peri-7/penduin/list.md

## Electronics
1. Stepper motor | 42BYGHW804, NEMA17 48 mm body, 4.8 kg·cm, 5 mm shaft
2. Stepper driver | TMC2209
3. Magnetic encoder | AS5600
4. Microcontroller | Raspberry Pi Pico 2 W
5. Electrolytic capacitor | 100 µF
6. Ceramic capacitor | 100 nF
7. Motor cable | 24V
8. Encoder wires | 30 AWG

## Mechanical
1. Vertical arm | 3D-printed
2. Pendulum | 3D-printed
3. Ball bearing | 608ZZ
4. Tip mass | 2 x 50 cent coins
