peri-7/penduin/data/excitation_plan.png

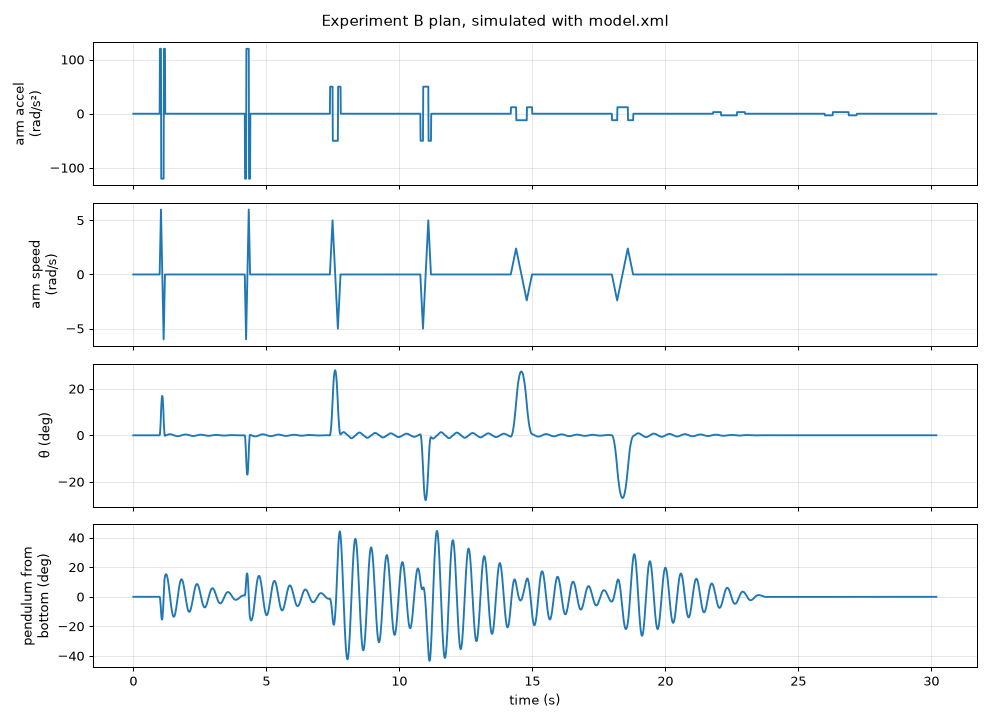
data/excitation_plan.png
