peri-7/penduin/data/sysid_A.png

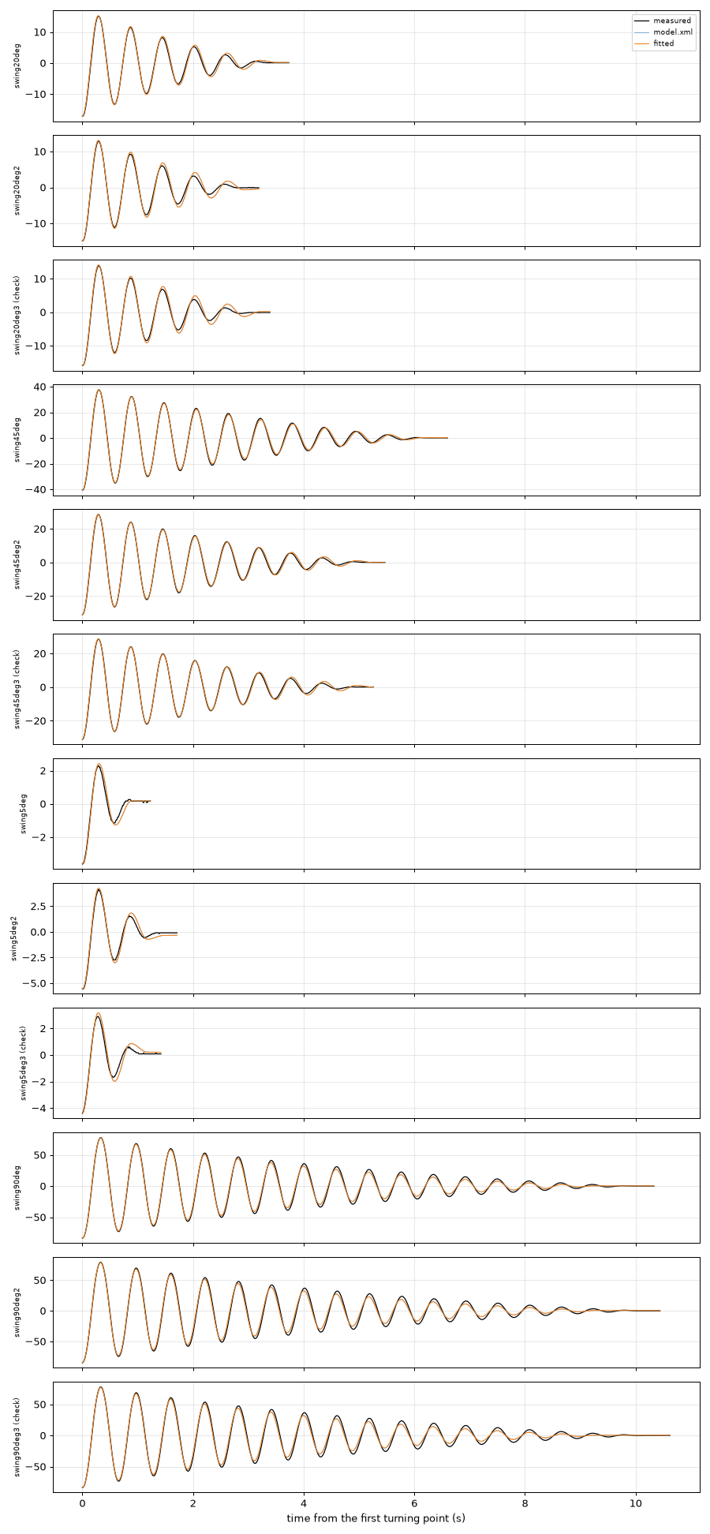
data/sysid_A.png
