peri-7/penduin/data/sysid_B.png

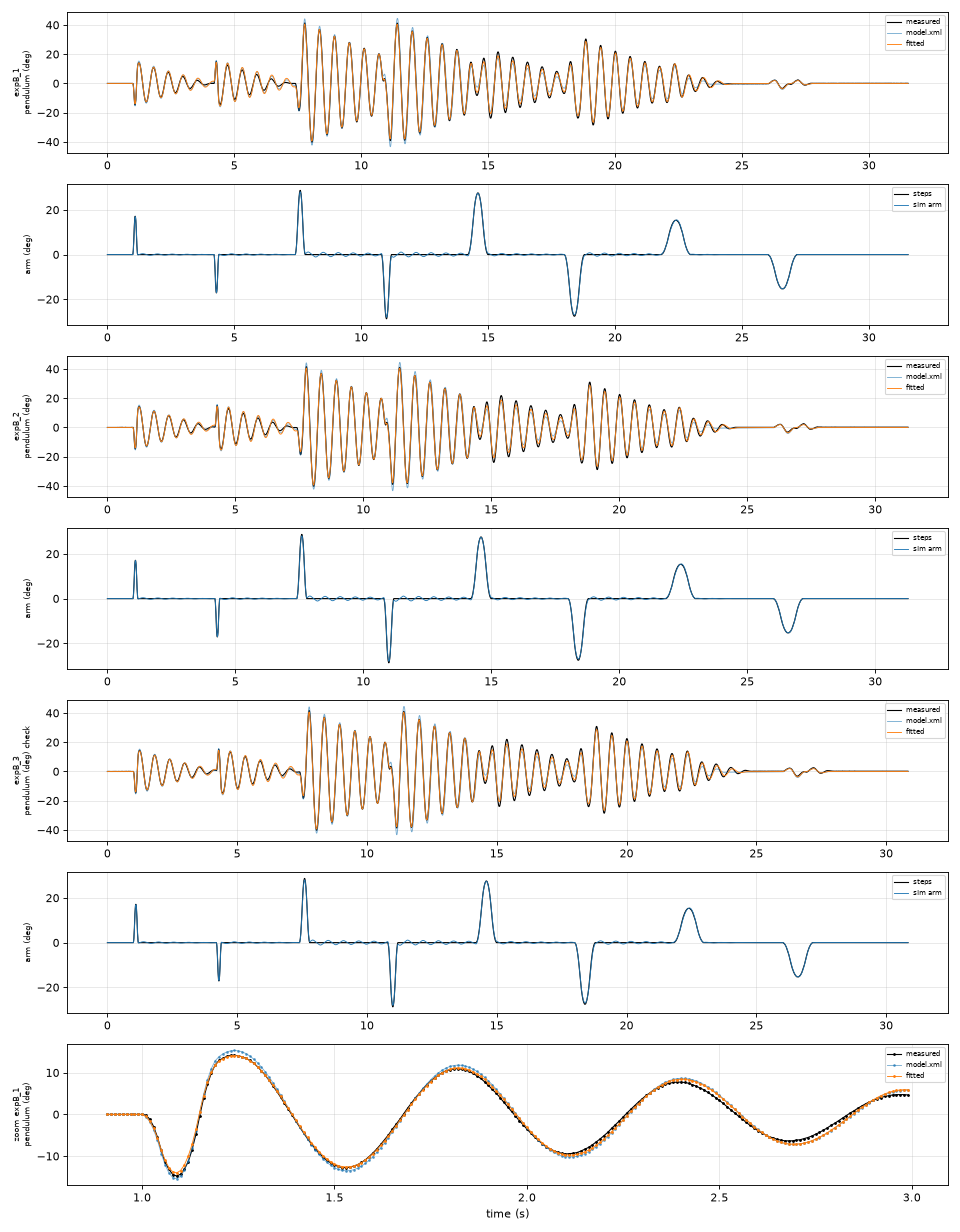
data/sysid_B.png
