peri-7/penduin/images/IMG_20261111_183600306.jpg

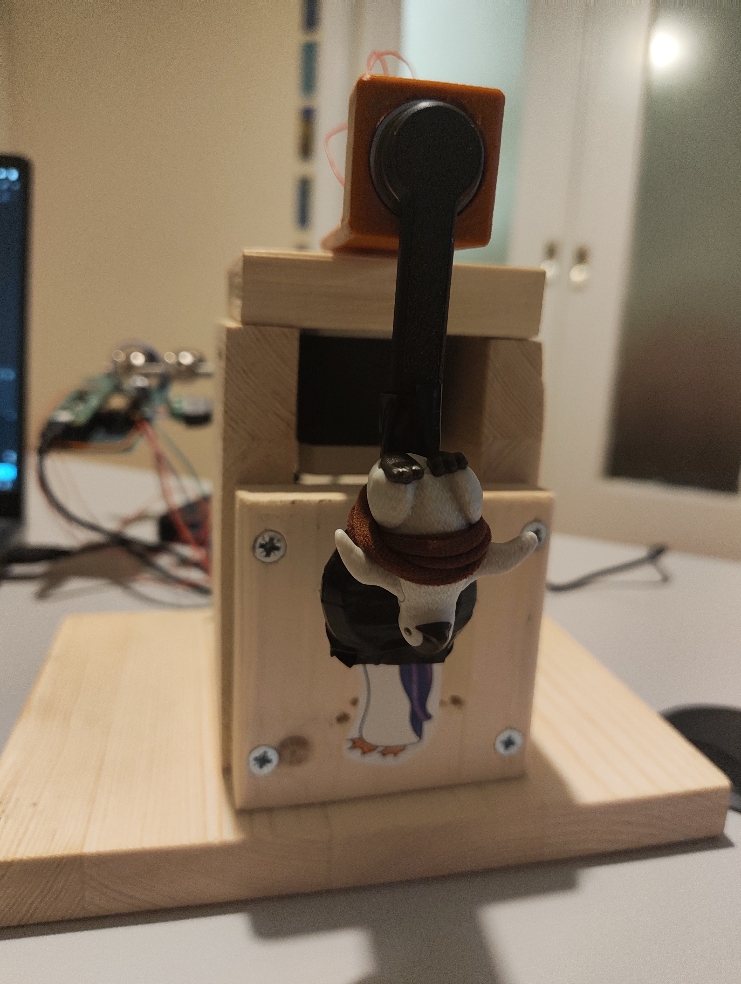
images/IMG_20261111_183600306.jpg
