peri-7/penduin/images/IMG_20261111_183626124.jpg

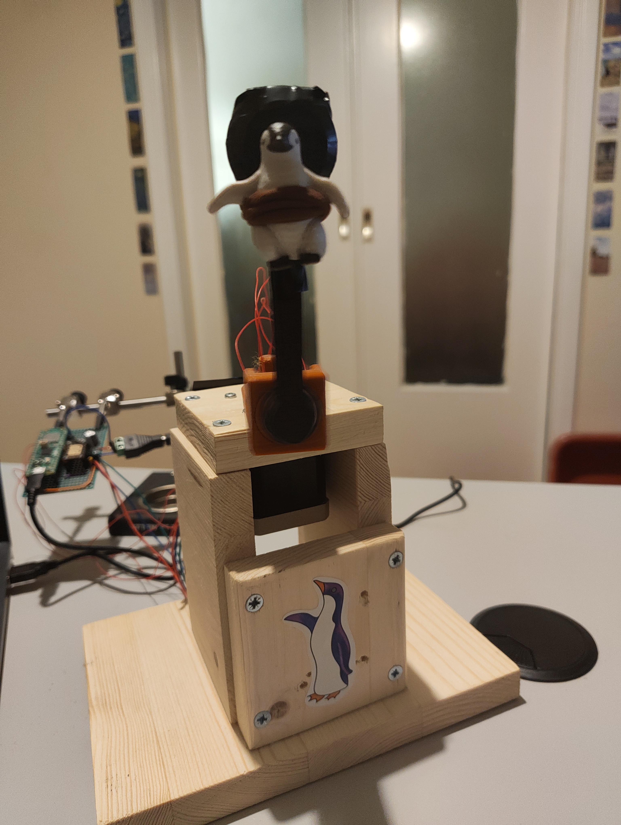
images/IMG_20261111_183626124.jpg
