peri-7/penduin/images/IMG_20261111_183635876.jpg

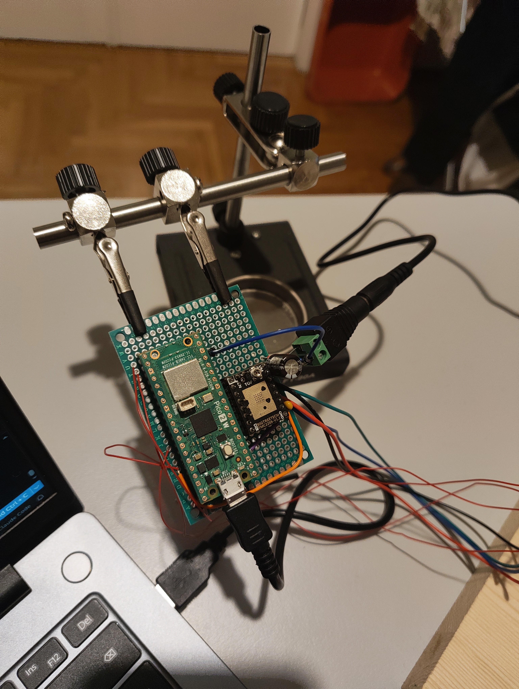
images/IMG_20261111_183635876.jpg
