peri-7/penduin/images/IMG_20261111_183653554.jpg

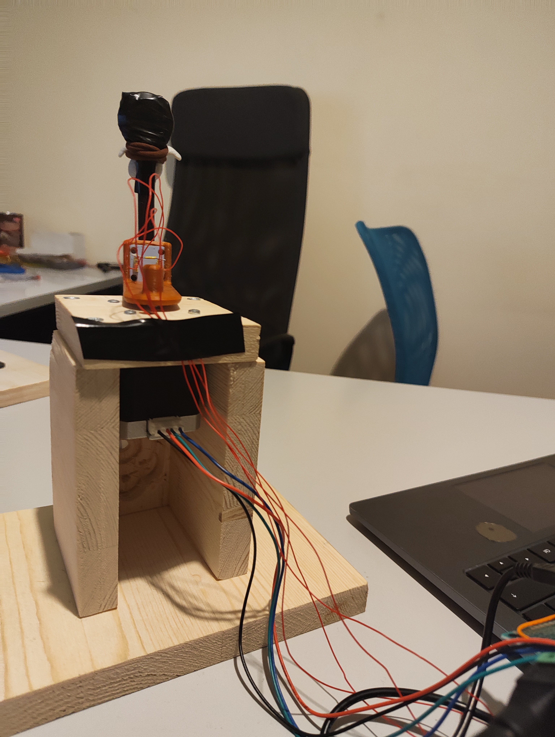
images/IMG_20261111_183653554.jpg
