peri-7/penduin/images/IMG_20261111_183659180.jpg

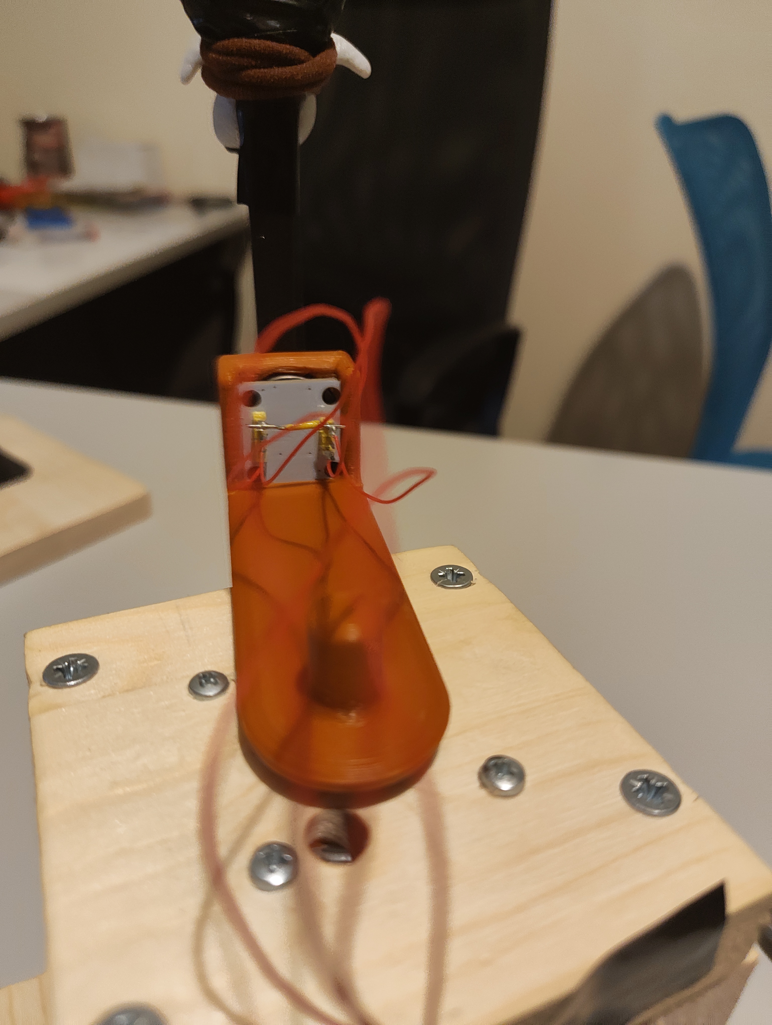
images/IMG_20261111_183659180.jpg
