peri-7/penduin/STLs/arm3.stl

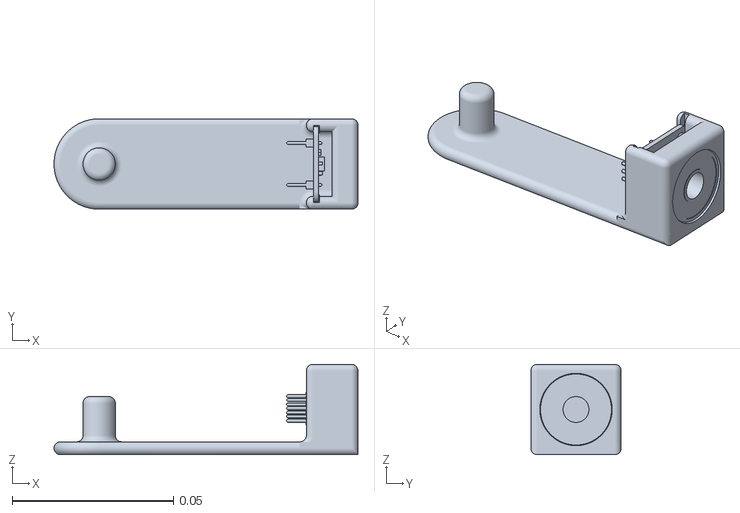
[picture p9: CAD file, 2026-11-04]
STLs/arm3.stl
0.0942 x 0.028 x 0.028
