peri-7/penduin/STLs/pendulum.stl

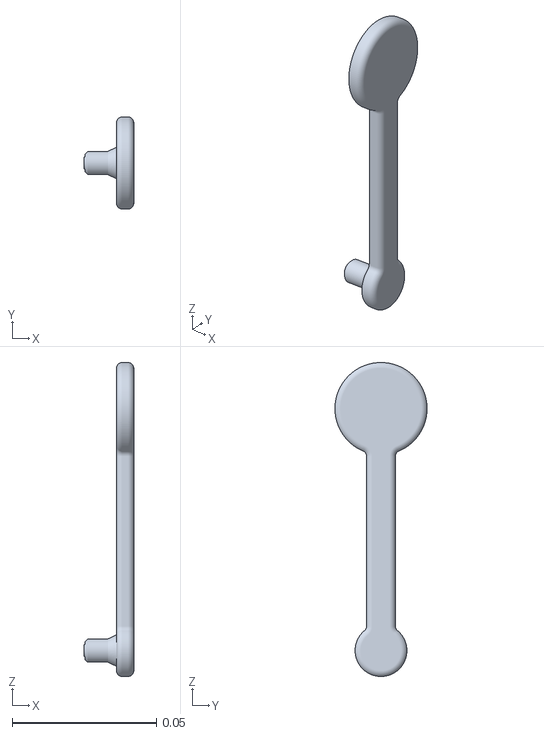
[picture p10: CAD file, 2026-10-31]
STLs/pendulum.stl
0.0172 x 0.032 x 0.109
