peri-7/penduin/STLs/arm.stl

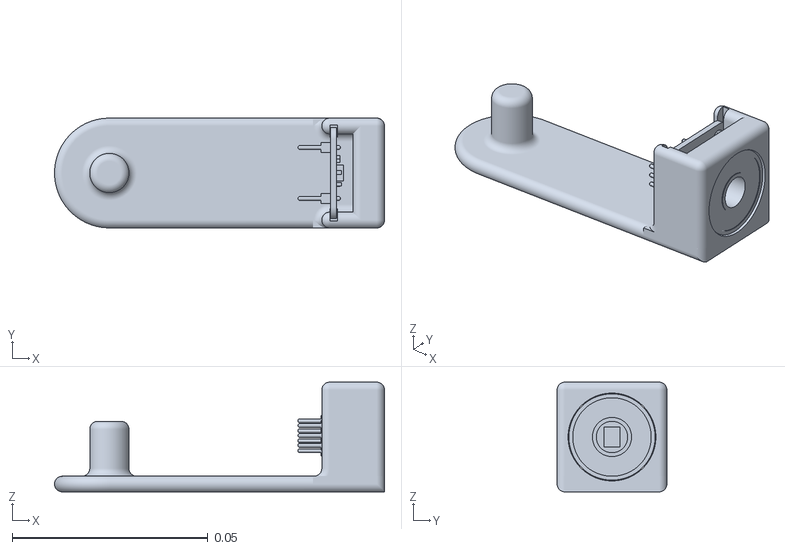
[picture p11: CAD file, 2026-10-31]
STLs/arm.stl
0.0842 x 0.028 x 0.028
