peri-7/penduin/STLs/nema17.stl

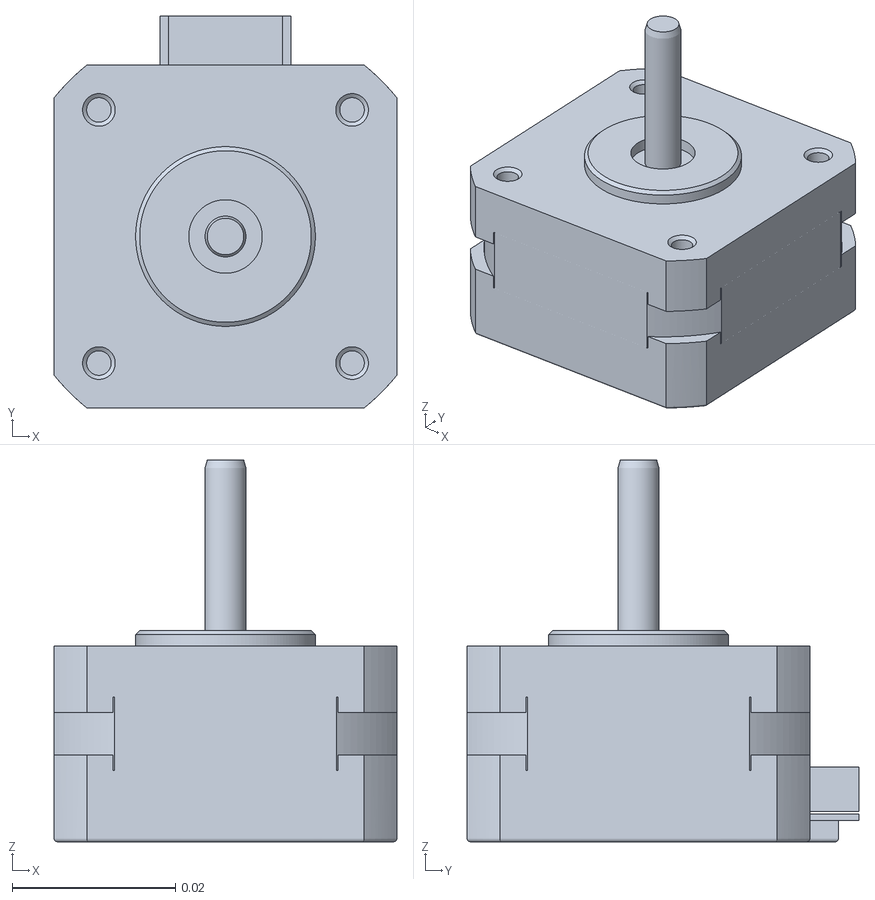
[picture p12: CAD file, 2026-10-31]
STLs/nema17.stl
0.042 x 0.048 x 0.0468
