peri-7/penduin/STLs/pendulum_coins.stl

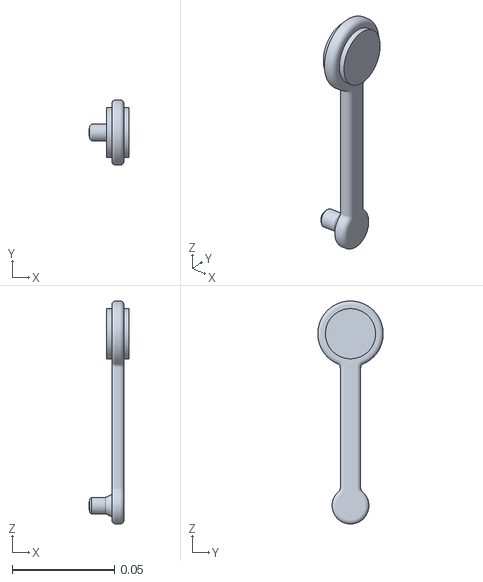
[picture p13: CAD file, 2026-10-31]
STLs/pendulum_coins.stl
0.0197 x 0.032 x 0.109
