peri-7/penduin/(list of files, cad)

Other CAD files:
STLs/pendulum2.stl
STLs/arm2.stl
STLs/body2.stl
