peri-7/penduin/data/swing_test.csv

# set_SF(2) returned 0 | conf 0x0300
time_us | raw
1456507087 | 3643
1456515157 | 3643
1456525157 | 3643
1456535157 | 3643
1456545157 | 3643
1456555157 | 3642
1456565157 | 3643
1456575157 | 3643
1456585157 | 3643
1456595157 | 3643
1456605157 | 3642
1456615157 | 3643
1456625157 | 3642
1456635157 | 3643
1456645157 | 3643
1456655157 | 3643
1456665157 | 3642
1456675157 | 3642
1456685157 | 3643
1456695157 | 3642
1456705157 | 3643
1456715157 | 3643
1456725157 | 3642
1456735157 | 3643
1456745157 | 3642
1456755157 | 3643
1456765157 | 3642
1456775157 | 3642
1456785157 | 3643
1456795157 | 3642
1456805157 | 3643
1456815157 | 3643
1456825157 | 3643
1456835157 | 3642
1456845157 | 3643
1456855157 | 3643
1456865157 | 3643
1456875157 | 3643
1456885157 | 3642
1456895157 | 3642
1456905157 | 3643
1456915157 | 3642
1456925157 | 3642
1456935157 | 3643
1456945157 | 3642
1456955157 | 3642
1456965157 | 3643
1456975157 | 3643
1456985157 | 3643
1456995157 | 3642
1457005157 | 3643
1457015157 | 3642
1457025157 | 3642
1457035157 | 3643
1457045157 | 3642
1457055157 | 3643
1457065157 | 3643
1457075157 | 3643
1457085157 | 3643
1457095157 | 3642
1457105157 | 3643
1457115157 | 3643
1457125157 | 3643
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
