peri-7/penduin/data/telemetry_idle_test.csv

# state: wait -> center the arm | then press any key to calibrate and run
# state: wait -> center the arm | then press any key to calibrate and run
# calibration ended -> raw_down: 3646 / raw_up: 1598
time_us | raw | steps | v | action | alpha | alpha_dot | loop_us | late | dropped
209435557 | 3645 | 0 | 0.000 | 0.000 | 3.1401 | 0.000 | 510 | 0 | 0
209445558 | 3645 | 0 | 0.000 | 0.000 | 3.1401 | 0.000 | 508 | 0 | 0
209455558 | 3645 | 0 | 0.000 | 0.000 | 3.1401 | 0.000 | 507 | 0 | 0
209465558 | 3646 | 0 | 0.000 | 0.000 | -3.1416 | 0.153 | 507 | 0 | 0
209475558 | 3646 | 0 | 0.000 | 0.000 | -3.1416 | 0.000 | 507 | 0 | 0
209485558 | 3645 | 0 | 0.000 | 0.000 | 3.1401 | -0.153 | 507 | 0 | 0
209495557 | 3646 | 0 | 0.000 | 0.000 | -3.1416 | 0.153 | 507 | 0 | 0
209505557 | 3646 | 0 | 0.000 | 0.000 | -3.1416 | 0.000 | 507 | 0 | 0
209515558 | 3646 | 0 | 0.000 | 0.000 | -3.1416 | 0.000 | 507 | 0 | 0
209525557 | 3645 | 0 | 0.000 | 0.000 | 3.1401 | -0.153 | 508 | 0 | 0
209535558 | 3646 | 0 | 0.000 | 0.000 | -3.1416 | 0.153 | 506 | 0 | 0
209545558 | 3645 | 0 | 0.000 | 0.000 | 3.1401 | -0.153 | 507 | 0 | 0
209555558 | 3645 | 0 | 0.000 | 0.000 | 3.1401 | 0.000 | 508 | 0 | 0
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
