peri-7/penduin/data/telemetry_isolation_test.csv

# state: wait -> center the arm | then press any key to calibrate and run
# calibration ended -> raw_down: 3644 / raw_up: 1596
time_us | raw | steps | v | action | alpha | alpha_dot | loop_us | late | dropped
1456130269 | 3644 | 0 | 0.000 | 0.000 | -3.1416 | 0.000 | 508 | 0 | 0
1456140270 | 3644 | 0 | 0.000 | 0.000 | -3.1416 | 0.000 | 507 | 0 | 0
1456150270 | 3644 | 0 | 0.000 | 0.000 | -3.1416 | 0.000 | 508 | 0 | 0
1456160269 | 3644 | 0 | 0.000 | 0.000 | -3.1416 | 0.000 | 508 | 0 | 0
1456170269 | 3644 | 0 | 0.000 | 0.000 | -3.1416 | 0.000 | 508 | 0 | 0
1456180270 | 3644 | 0 | 0.000 | 0.000 | -3.1416 | 0.000 | 507 | 0 | 0
1456190269 | 3644 | 0 | 0.000 | 0.000 | -3.1416 | 0.000 | 508 | 0 | 0
1456200270 | 3644 | 0 | 0.000 | 0.000 | -3.1416 | 0.000 | 507 | 0 | 0
1456210270 | 3645 | 0 | 0.000 | 0.000 | -3.1401 | 0.153 | 507 | 0 | 0
1456220270 | 3644 | 0 | 0.000 | 0.000 | -3.1416 | -0.153 | 506 | 0 | 0
1456230269 | 3644 | 0 | 0.000 | 0.000 | -3.1416 | 0.000 | 508 | 0 | 0
1456240270 | 3645 | 0 | 0.000 | 0.000 | -3.1401 | 0.153 | 508 | 0 | 0
1456250269 | 3645 | 0 | 0.000 | 0.000 | -3.1401 | 0.000 | 507 | 0 | 0
1456260270 | 3645 | 0 | 0.000 | 0.000 | -3.1401 | 0.000 | 507 | 0 | 0
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
