peri-7/penduin/firmware/stepper_motor/main.c

// control loop
#include <stdio.h>
#include <pico/stdlib.h>
#include <math.h>
#include <pico/stdio_usb.h>
#include <pico/multicore.h>
#include <pico/util/queue.h>
#include <hardware/watchdog.h>

#include "stepper.h"
#include "encoder.h"
#include "agent.h"

#define DT_US 10000
#define DT (DT_US * 1e-6f)
#define SF 2
#define FAILED_CNTS 3
#define CAL_N 100
#define CAL_SPREAD 4

static PIO pio;
static uint sm0, sm1, baud = 100*1000;
static alpha_t a;
static float th, th_dot, th_ddot, action;
static int32_t steps0;
static const char *reason = "";

static int cnt = 0, restart = 0;
static uint16_t raw = 0;

static queue_t write_q, read_q;

typedef enum STATES {
    WAIT, CALIBRATE, RUN, FAULT 
} state_t;

typedef struct {
    uint32_t t_us; 
    float a;
    float a_dot;
    float th;
    float th_dot;
    float action;
} obs_t;

static void core1_main(void){
    while(true){
        obs_t obs; // placeholder in case we need it, perhaps the observation space
        while(queue_try_remove(&write_q, &obs)) 
            printf("%lu,%f,%f,%f,%f,%f\n", (unsigned long)obs.t_us, obs.a, obs.a_dot, obs.th, obs.th_dot, obs.action);
        int c = getchar_timeout_us(0);
        if(c != PICO_ERROR_TIMEOUT) {
            char k = (char)c;
            queue_try_add(&read_q, &k);
        }
        sleep_ms(1);
    }
}
/*  Given by the agent.c script now
static float controller(float a, float a_dot, float th, float th_dot){
    if (fabs(a) < 0.15) 
        return -(-8.61077392*th + 398.98540392*a  -6.56925727*th_dot + 33.09880381*a_dot); // placeholder for tests
    else return 0;
} */



// Bench check of the exported network, run once at boot with the motor still.
// Expected values for checkpoints/sac_QR101_675000_steps (recompute them for another model):
//   +0.988925, -0.516716, +0.466328, -0.923270
static void agent_selftest(void){
    const float in[4][4] = {    // a, a_dot, th, th_dot (raw rad, rad/s: controller() scales them)
        { 3.141593f,  0.0f,  0.0f,  0.0f},
        { 0.1f,       0.5f,  0.2f,  1.0f},
        {-0.05f,     -1.0f, -0.3f, -2.0f},
        { 2.0f,       5.0f,  0.5f,  8.0f},
    };
    for(int k=0; k<4; k++)
        printf("# selftest: controller(%f, %f, %f, %f) = %f\n", in[k][0], in[k][1], in[k][2], in[k][3],
               controller(in[k][0], in[k][1], in[k][2], in[k][3]));

    // time 100 calls: mean and worst case
    uint32_t total = 0, worst = 0;
    float sink = 0;     // printed, so the calls can't be optimized away
    for(int k=0; k<100; k++){
        const float *x = in[k % 4];
        uint32_t t0 = time_us_32();
        sink += controller(x[0], x[1], x[2], x[3]);
        uint32_t d = time_us_32() - t0;
        total += d;
        if(d > worst) worst = d;
    }
    printf("# selftest: controller() mean %.1f us, worst %lu us (sink %f)\n",
           total / 100.0f, (unsigned long)worst, sink);
}

int calibrate(){
    // take 100 measurments of raw_down
    uint16_t cal[CAL_N]; 
    absolute_time_t next = get_absolute_time();
    for(int k=0; k<CAL_N; k++){
        next = delayed_by_us(next, DT_US);
        if(read_raw_angle(i2c0, &cal[k]) != 2){
            reason = "read failures";
            printf("# state: calibrate -> read failed during calibration\n");
            return -1;
        }
        sleep_until(next);
    }
    // find the spread to check stillness
    int lo = 0, hi = 0;
    for(int k=0; k<CAL_N; k++){
        int d = wrap_counts((int)cal[k] - (int)cal[0]);
        if(d < lo) lo = d;
        if(d > hi) hi = d;
    }
    if(hi - lo > CAL_SPREAD){
        reason = "pend. not still";
        printf("# state: calibrate -> pendulum not still: spread %d counts. Let it settle and run again\n", hi - lo);
        return 1;
    }
    // compute raw_up and start alpha_t a
    uint16_t raw_down = raw_average(cal, CAL_N);
    a.raw_up = (raw_down + 2048) % 4096;

    printf("# calibration ended -> raw_down: %d / raw_up: %d\n", raw_down, a.raw_up);
    return 0;

}

int main()
{
    // init all hardware
    char key = 'a'; obs_t obs;
    // stdio_usb_init() must run on core 0 (it owns the default alarm pool), or it returns false and USB never enumerates
    stdio_init_all();
    queue_init(&write_q, sizeof(obs_t), 64); 
    queue_init(&read_q, sizeof(char), 64);
    multicore_launch_core1(core1_main);
    while(!stdio_usb_connected()) sleep_ms(100);
    if(watchdog_enable_caused_reboot()) printf("# rebooted by watchdog\n");
    as5600_init(i2c0, baud, SDA_PIN, CLK_PIN);
    init_move_pio(&pio, &sm0);
    init_read_pio(&pio, &sm1);
    agent_selftest();
    state_t st = WAIT;


    absolute_time_t next = get_absolute_time();
    while (true) {
// ------------------------------------------------------------------------        
        if (st == WAIT){
            watchdog_disable();
            // while WAIT, move the arm at theta=0
            absolute_time_t prompt = get_absolute_time();
            while(!queue_try_remove(&read_q, &key)){
                if(time_reached(prompt)){
                    printf("# state: wait -> center the arm, then press s to calibrate and run\n");
                    prompt = make_timeout_time_ms(2000);
                }
                sleep_ms(10);
            }
            st = CALIBRATE;

        }
// ------------------------------------------------------------------------
        if (st == CALIBRATE){
            int err = set_SF(i2c0, SF);
            if (err != 0) { reason = "SF failure"; st = FAULT; continue; }
            int c = calibrate();
            if (c == 0) {
                while(queue_try_remove(&read_q, &key)); // empty queue
                cnt = 0; restart = 1; 
                th_dot = 0; th_ddot = 0; 
                steps0 = read_steps(pio, sm1);
                
                printf("t_us,alpha,alpha_dot,theta,theta_dot,action\n");
                watchdog_enable(50, true);
                next = get_absolute_time();
                st = RUN;
            }
            else if (c == 1) st = WAIT;
            else st = FAULT; 
        }
// ------------------------------------------------------------------------        
        if (st == RUN){
            next = delayed_by_us(next, DT_US);
            watchdog_update();
            // stop RUN if key is pressed
            if(queue_try_remove(&read_q, &key)) {
                // if(key == 'w') while(1) ; // watchdog test
                set_speed(0, pio, sm0);
                st = WAIT;
                continue;
            }
            // read angle 'alpha' and 'theta'
            if(read_raw_angle(i2c0, &raw) != 2){
                restart = 1;
                if(++cnt >= FAILED_CNTS){
                    reason = "read failures";
                    st = FAULT;
                    continue;
                }
            }
            else {
                cnt = 0; 
                if (restart == 1) {
                    alpha_start(&a, raw);
                    restart = 0;
                }
                else
                    alpha_update(&a, raw, DT);
            }
            th = steps2rad(pio, sm1, steps0);
            if(fabsf(th) > TH_LIMIT){
                reason = "theta passed the limit";
                st = FAULT;
                continue;                
            }
            
            // control u = th_ddot -> command th_dot
            action = controller(a.alpha, a.alpha_dot, th, th_dot);
            if(action > 1) action = 1;
            if(action < -1) action = -1;
            th_ddot = action*MAX_ACCEL;
            th_dot = th_dot + th_ddot*DT;
            if(th_dot > VMAX) th_dot = VMAX;
            if(th_dot < -VMAX) th_dot = -VMAX;
            set_speed(th_dot, pio, sm0);

            // telemetry: queued here, printed by core 1 (never print on core 0 in RUN)
            obs.t_us = time_us_32();
            obs.a = a.alpha; obs.a_dot = a.alpha_dot;
            obs.th = th; obs.th_dot = th_dot;
            obs.action = action;
            queue_try_add(&write_q, &obs);

            sleep_until(next);
        }
        
// ------------------------------------------------------------------------       
        if (st == FAULT){
            watchdog_disable();
            set_speed(0, pio, sm0);

            printf("# state: fault -> reason (%s) -> press 'r' to restart\n", reason);
            queue_remove_blocking(&read_q, &key);
            if (key == 'r') st = WAIT;
            
        }
    }
}
