peri-7/penduin/firmware/stepper_motor/weights.h

#ifndef WEIGHTS_H_
#define WEIGHTS_H_

#define HID_DIM 128
#define OBS_DIM 5

float latent_pi_0_weight[640] = {
    1.00472367e+00f, 8.57551303e-03f, -4.38878477e-01f, 9.96006668e-01f, -1.27572465e+00f, 3.03815365e-01f, 2.42288083e-01f, -1.78152174e-01f, 7.76956677e-01f, -2.45711595e-01f, 3.64170432e-01f, 2.07262874e-01f, 6.49802327e-01f, -3.54047269e-02f, -8.72977853e-01f, 6.44448042e-01f, 2.36154646e-01f, -2.82429993e-01f, 8.34474385e-01f, -4.54063684e-01f, -7.36880898e-01f, -3.62128258e-01f, 2.84556299e-01f, -1.08680224e+00f, 6.62827611e-01f, -1.07019663e+00f, 3.27106416e-01f, 4.48049754e-01f, -1.79349804e+00f, 8.35971773e-01f, -4.97868001e-01f, -1.70328572e-01f, 7.49748528e-01f, -8.04345787e-01f, 1.11326969e+00f, -1.65094063e-01f, -4.21123244e-02f, 2.73985267e-02f, 2.43213281e-01f, -7.24527955e-01f, 9.05886412e-01f, -5.49808621e-01f, 9.73998383e-02f, 1.38167918e-01f, -3.35405797e-01f, -4.78786379e-01f, -8.12184155e-01f, -2.79765695e-01f, -3.43021810e-01f, -1.35856882e-01f, -3.69427532e-01f, 1.03107922e-01f, 9.48176920e-01f, -1.50789008e-01f, 8.83288562e-01f, -7.99347937e-01f, 9.22553055e-03f, 6.43830895e-02f, -1.24776173e+00f, 3.38700294e-01f, 2.13911653e-01f, -1.07026689e-01f, 4.92457777e-01f, 1.64197445e+00f, 3.40656817e-01f, -8.42467487e-01f, 2.23995205e-02f, 3.20302904e-01f, -7.87458479e-01f, -7.24197805e-01f, -7.16100857e-02f, 3.68690819e-01f, 3.53721678e-01f, -9.41933393e-01f, 6.87083185e-01f, -1.29606977e-01f, -1.34506851e-01f, 1.71444431e-01f, -9.48713362e-01f, 9.83336866e-02f, 5.70309818e-01f, -1.83577687e-01f, 2.59470463e-01f, 8.36640060e-01f, -1.20214328e-01f, -3.7438553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
};

float latent_pi_2_weight[16384] = {
    1.12401359e-01f, -3.15009244e-02f, 6.83705330e-01f, 1.97763473e-01f, 1.06157012e-01f, 8.29832852e-02f, -5.43609321e-01f, 2.31251001e-01f, 1.80339962e-01f, -8.72095048e-01f, 3.55085939e-01f, -4.34811503e-01f, 5.27683459e-02f, 1.60577977e+00f, 3.97738993e-01f, 6.60138786e-01f, -5.31487048e-01f, -5.76764464e-01f, 4.03484523e-01f, -7.51799166e-01f, 1.09941065e-01f, -9.92251813e-01f, 3.79675090e-01f, 6.17093325e-01f, -8.05040956e-01f, -6.89531416e-02f, -8.73450935e-03f, 8.42211485e-01f, 5.32076299e-01f, 5.89501858e-01f, 2.70467512e-02f, 5.43760359e-01f, 3.22215497e-01f, 1.43003196e-01f, -1.35330248e+00f, 5.53232357e-02f, 2.07693148e-02f, 2.61616647e-01f, -3.50872338e-01f, -2.97696352e-01f, 2.62606759e-02f, -1.19143926e-01f, -4.05192941e-01f, 1.14445060e-01f, -8.65128711e-02f, -3.19685601e-02f, 3.59220028e-01f, -1.31506145e-01f, -3.96722406e-02f, 6.66336238e-01f, -9.47368667e-02f, 1.16223693e+00f, 1.99315026e-01f, 2.86107868e-01f, 2.89244503e-01f, -8.02110016e-01f, 1.76947683e-01f, -1.09766829e+00f, 1.16723783e-01f, 1.53567687e-01f, -5.35747856e-02f, -2.29145527e-01f, 4.45593864e-01f, -2.48297304e-01f, -2.41535068e+00f, -4.76480007e-01f, 2.18499497e-01f, 6.99046969e-01f, 5.10642044e-02f, -1.30138159e+00f, -2.23810625e+00f, 1.12523913e-01f, -4.59201455e-01f, -4.36225593e-01f, -1.80413887e-01f, 2.79293329e-01f, -1.29035071e-01f, -1.87266633e-01f, -2.63492703e-01f, 4.78419006e-01f, 4.19387579e-01f, 3.38403821e-01f, 1.26486421e-01f, 1.33438602e-01f, 1.36401564e-01f, -4.43843827e-02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
