peri-7/penduin/(commit log)

2026-10-31 .xml file + the STLs for mujoco. Also python scripts for gym env, training and evaluation. model and checkpoints for 1st reward function
    [arm.stl, arm2.stl, body2.stl, nema17.stl, pendulum.stl, pendulum2.stl, pendulum_coins.stl]
2026-11-04 stepper.pio->move.pio / created read.pio to count steps / moved stepper related function from main to a header file"
    [arm3.stl]
2026-11-05 add smoothness metrics to summary report
    Added smoothness report to summary output including action differences, zero crossings, and velocity variance.
2026-11-05 encoder test
2026-11-08 just soldered perfectly
2026-11-08 system identification csv
    [swing20deg.csv, swing20deg2.csv, swing20deg3.csv, swing45deg.csv, swing45deg2.csv, swing45deg3.csv, swing5deg.csv, swing5deg2.csv]
2026-11-09 added record printing for sysid.B
2026-11-09 testing que connections for printf and getchar with core1
    [telemetry_idle_test.csv, telemetry_isolation_test.csv]
2026-11-09 small bugs in previous commit
    [telemetry_isolation_test.csv]
2026-11-09 small bugs in previous commit + expB csvs
    [expB_1.csv, expB_2.csv, expB_3.csv]
2026-11-09 small bugs in previous commit again...
    [main.c]
